The-Stargazist/astro-avionics/vada/VADA.step

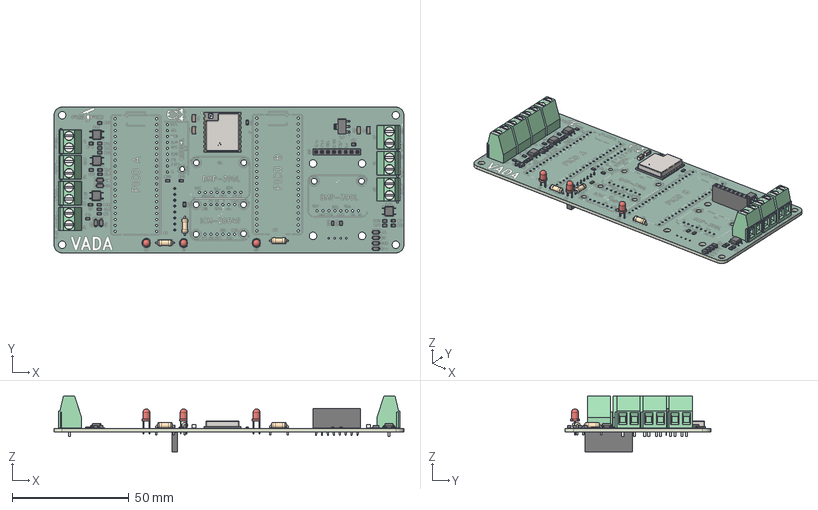
[picture p1: CAD file, 2026-05-24]
vada/VADA.step
150.0 x 62.5 x 24.0 mm
R_0805_2012Metric x 24
TerminalBlock_Phoenix_MKDS-1,5-2_1x02_P5.00mm_Horizontal x 7
WIRELM-SMD_L17.0-W16.0-H3.2-RA-02
D_SOD-123F x 8
LED_D3.0mm x 3
C_1206_3216Metric x 4
SOP-4_3.8x4.1mm_P2.54mm x 4
R_Axial_DIN0207_L6.3mm_D2.5mm_P7.62mm_Horizontal x 3
PinSocket_1x08_P2.54mm_Vertical x 2
SOT-223
VADA_silkscreen
VADA_soldermask
VADA_PCB
