The-Stargazist/astro-avionics/vada/VADA.kicad_pcb

## KiCad design vada/VADA.kicad_pcb (2026-05-24)

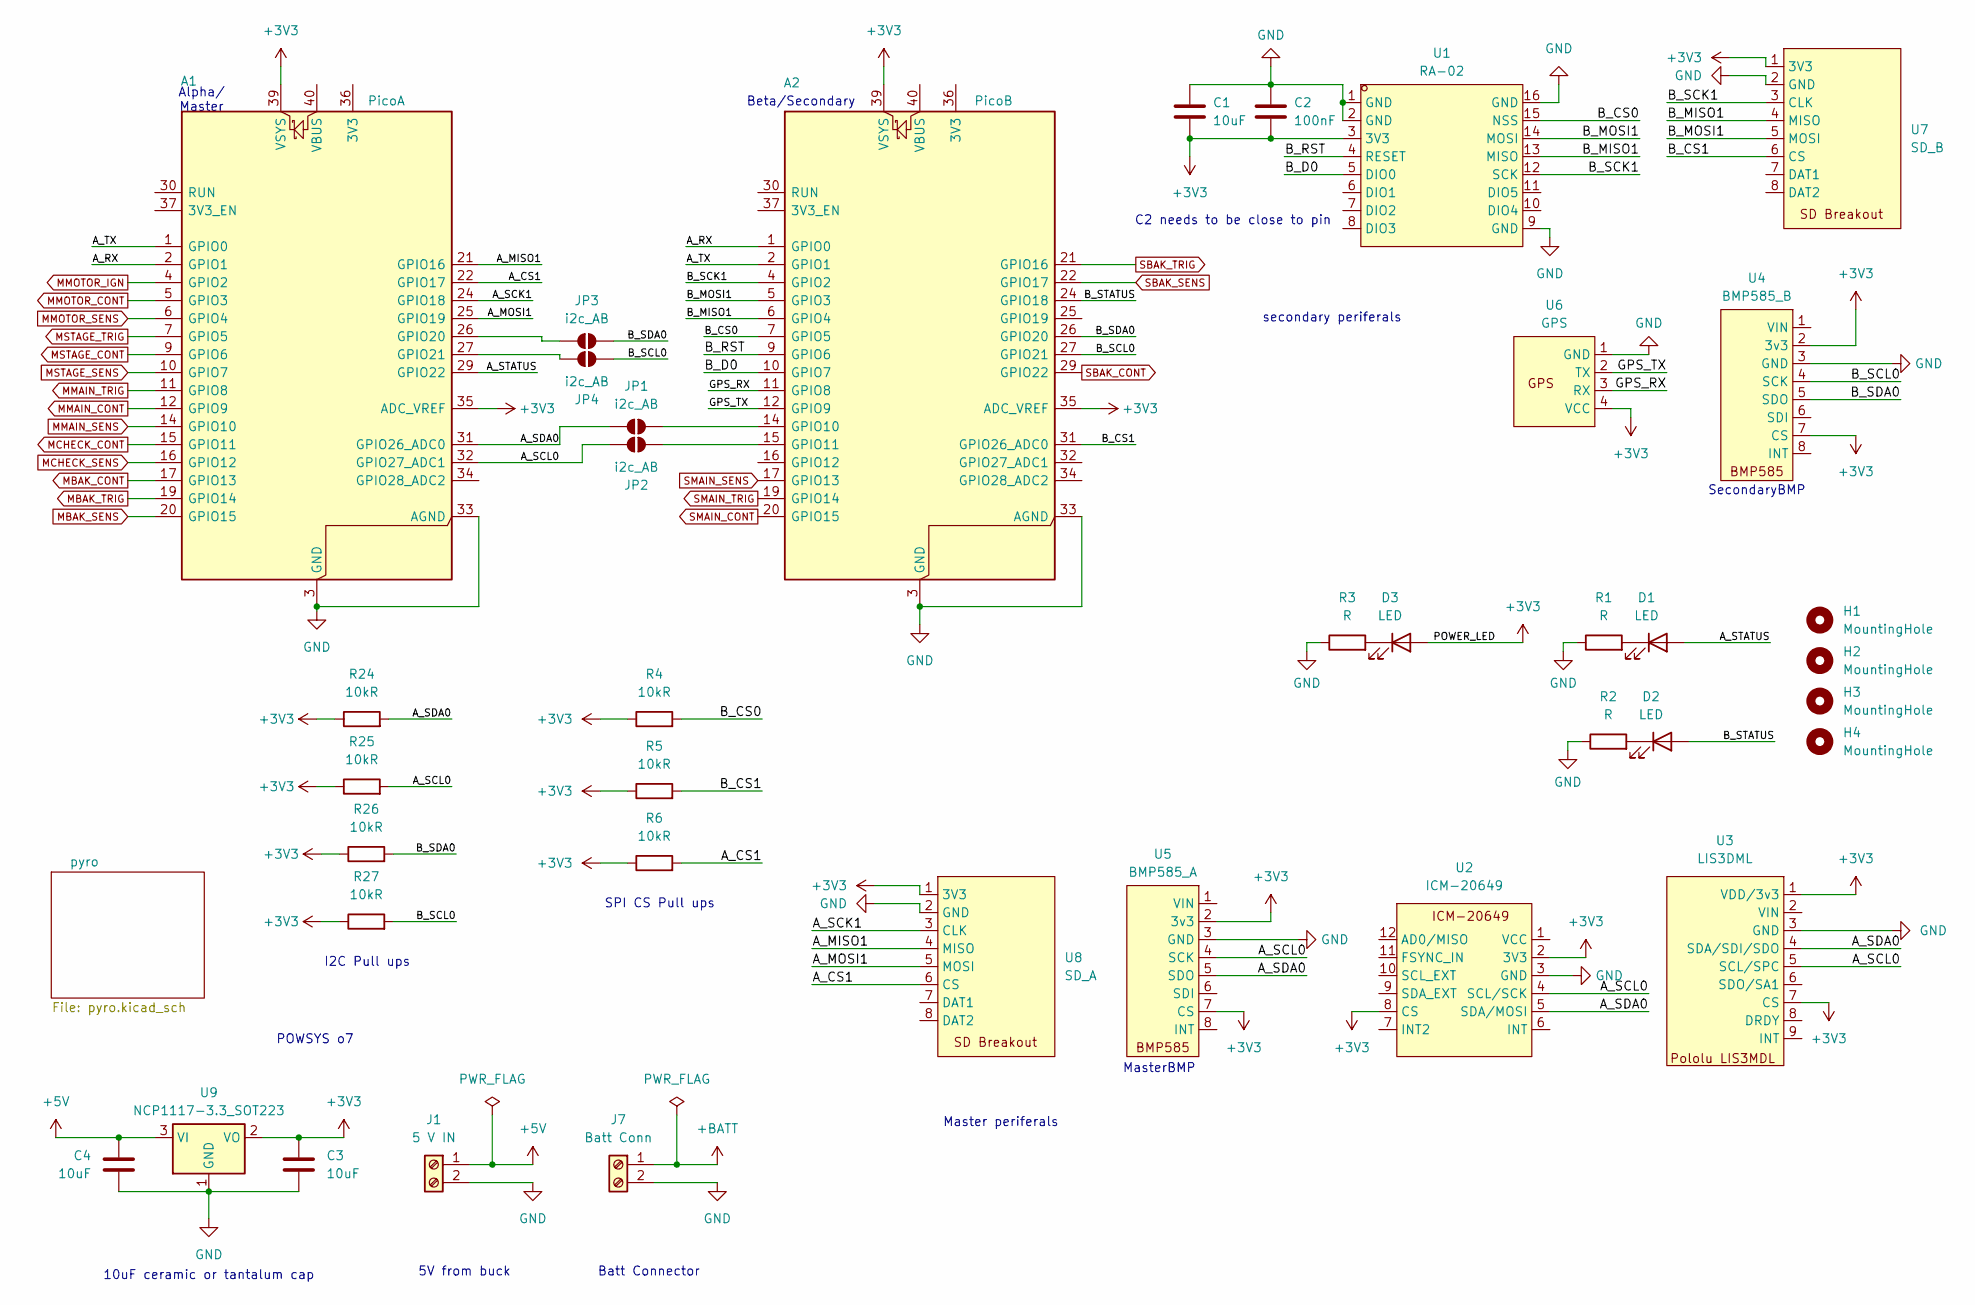
[picture p2: schematic VADA.kicad_sch, Very ADvance Avionics]

Parts:
A1: PicoA; RaspberryPi_Pico_Common_THT
A2: PicoB; RaspberryPi_Pico_Common_THT
C1, C3, C4: 10uF; C_1206_3216Metric_Pad1.33x1.80mm_HandSolder
C2: 100nF; C_1206_3216Metric_Pad1.33x1.80mm_HandSolder
D1, D2, D3: LED; LED_D3.0mm
H1, H2, H3, H4: MountingHole; MountingHole_3.2mm_M3
J1: 5 V IN; TerminalBlock_Phoenix_MKDS-1,5-2_1x02_P5.00mm_Horizontal
J7: Batt Conn; TerminalBlock_Phoenix_MKDS-1,5-2_1x02_P5.00mm_Horizontal
JP1, JP2, JP3, JP4: i2c_AB; SolderJumper-2_P1.3mm_Open_Pad1.0x1.5mm
R1, R2, R3: R; R_Axial_DIN0207_L6.3mm_D2.5mm_P7.62mm_Horizontal
R4, R5, R6, R24, R25, R26, R27: 10kR; R_0805_2012Metric_Pad1.20x1.40mm_HandSolder
U1: RA-02; WIRELM-SMD_RA-02-BL; LCSC Part C90039
U2: ICM-20649
U3: LIS3DML; Pololu LIS3DML
U4: BMP585_B; BMP-390L
U5: BMP585_A; BMP-390L
U6: GPS; M8N GPS
U7: SD_B; PinSocket_1x08_P2.54mm_Vertical
U8: SD_A; PinSocket_1x08_P2.54mm_Vertical
U9: NCP1117-3.3_SOT223; SOT-223-3_TabPin2

Connections:
+3V3: A1.35 (ADC_VREF), A1.39 (VSYS), A2.35 (ADC_VREF), A2.39 (VSYS), C1.2, C2.2, C3.1, D3.2 (A), R4.1, R5.1, R6.1, R24.1, R25.1, R26.1, R27.1, U1.3 (3V3), U2.2 (3V3), U2.8 (CS), U3.1 (VDD/3v3), U3.7 (CS), U4.2 (3v3), U4.7 (CS), U5.2 (3v3), U5.7 (CS), U6.4 (VCC), U7.1 (3V3), U8.1 (3V3), U9.2 (VO)
+5V: C4.1, J1.1, U9.3 (VI)
+BATT: J7.1; also elsewhere on the board
/A_CS1: A1.22 (GPIO17), R6.2, U8.6 (CS)
/A_MISO1: A1.21 (GPIO16), U8.4 (MISO)
/A_MOSI1: A1.25 (GPIO19), U8.5 (MOSI)
/A_RX: A1.2 (GPIO1), A2.1 (GPIO0)
/A_SCK1: A1.24 (GPIO18), U8.3 (CLK)
/A_SCL0: A1.32 (GPIO27_ADC1), JP2.1 (A), R25.2, U2.4 (SCL/SCK), U3.5 (SCL/SPC), U5.4 (SCK)
/A_SDA0: A1.31 (GPIO26_ADC0), JP1.1 (A), R24.2, U2.5 (SDA/MOSI), U3.4 (SDA/SDI/SDO), U5.5 (SDO)
/A_STATUS: A1.29 (GPIO22), D1.2 (A)
/A_TX: A1.1 (GPIO0), A2.2 (GPIO1)
/B_CS0: A2.7 (GPIO5), R4.2, U1.15 (NSS)
/B_CS1: A2.31 (GPIO26_ADC0), R5.2, U7.6 (CS)
/B_D0: A2.10 (GPIO7), U1.5 (DIO0)
/B_MISO1: A2.6 (GPIO4), U1.13 (MISO), U7.4 (MISO)
/B_MOSI1: A2.5 (GPIO3), U1.14 (MOSI), U7.5 (MOSI)
/B_RST: A2.9 (GPIO6), U1.4 (RESET)
/B_SCK1: A2.4 (GPIO2), U1.12 (SCK), U7.3 (CLK)
/B_SCL0: A2.27 (GPIO21), JP4.2 (B), R27.2, U4.4 (SCK)
/B_SDA0: A2.26 (GPIO20), JP3.2 (B), R26.2, U4.5 (SDO)
/B_STATUS: A2.24 (GPIO18), D2.2 (A)
/GPS_RX: A2.11 (GPIO8), U6.3 (RX)
/GPS_TX: A2.12 (GPIO9), U6.2 (TX)
GND: A1.3 (GND), A1.8 (GND), A1.13 (GND), A1.18 (GND), A1.23 (GND), A1.28 (GND), A1.33 (AGND), A1.38 (GND), A2.3 (GND), A2.8 (GND), A2.13 (GND), A2.18 (GND), A2.23 (GND), A2.28 (GND), A2.33 (AGND), A2.38 (GND), C1.1, C2.1, C3.2, C4.2, J1.2, J7.2, R1.1, R2.1, R3.1, U1.1 (GND), U1.2 (GND), U1.9 (GND), U1.16 (GND), U2.3 (GND), U3.3 (GND), U4.3 (GND), U5.3 (GND), U6.1 (GND), U7.2 (GND), U8.2 (GND), U9.1 (GND); also elsewhere on the board
MBAK_CONT: A1.17 (GPIO13); also elsewhere on the board
MBAK_SENS: A1.20 (GPIO15), A2.22 (GPIO17); also elsewhere on the board
MBAK_TRIG: A1.19 (GPIO14); also elsewhere on the board
MCHECK_CONT: A1.15 (GPIO11); also elsewhere on the board
MCHECK_SENS: A1.16 (GPIO12); also elsewhere on the board
MMAIN_CONT: A1.12 (GPIO9); also elsewhere on the board
MMAIN_SENS: A1.14 (GPIO10), A2.17 (GPIO13); also elsewhere on the board
MMAIN_TRIG: A1.11 (GPIO8); also elsewhere on the board
MMOTOR_CONT: A1.5 (GPIO3); also elsewhere on the board
MMOTOR_IGN: A1.4 (GPIO2); also elsewhere on the board
MMOTOR_SENS: A1.6 (GPIO4); also elsewhere on the board
MSTAGE_CONT: A1.9 (GPIO6); also elsewhere on the board
MSTAGE_SENS: A1.10 (GPIO7); also elsewhere on the board
MSTAGE_TRIG: A1.7 (GPIO5); also elsewhere on the board
unnamed: A1.26 (GPIO20), JP3.1 (A)
unnamed: A1.27 (GPIO21), JP4.1 (A)
unnamed: A2.14 (GPIO10), JP1.2 (B)
unnamed: A2.15 (GPIO11), JP2.2 (B)
unnamed: D1.1 (K), R1.2
unnamed: D2.1 (K), R2.2
unnamed: D3.1 (K), R3.2
SBAK_CONT: A2.29 (GPIO22); also elsewhere on the board
SBAK_TRIG: A2.21 (GPIO16); also elsewhere on the board
SMAIN_CONT: A2.20 (GPIO15); also elsewhere on the board
SMAIN_TRIG: A2.19 (GPIO14); also elsewhere on the board

Notes on the sheet:
10uF ceramic or tantalum cap
5V from buck
C2 needs to be close to pin
Batt Connector
SPI CS Pull ups
MasterBMP
Alpha/ Master
Master periferals
POWSYS o7
I2C Pull ups
secondary periferals
SecondaryBMP
Beta/Secondary

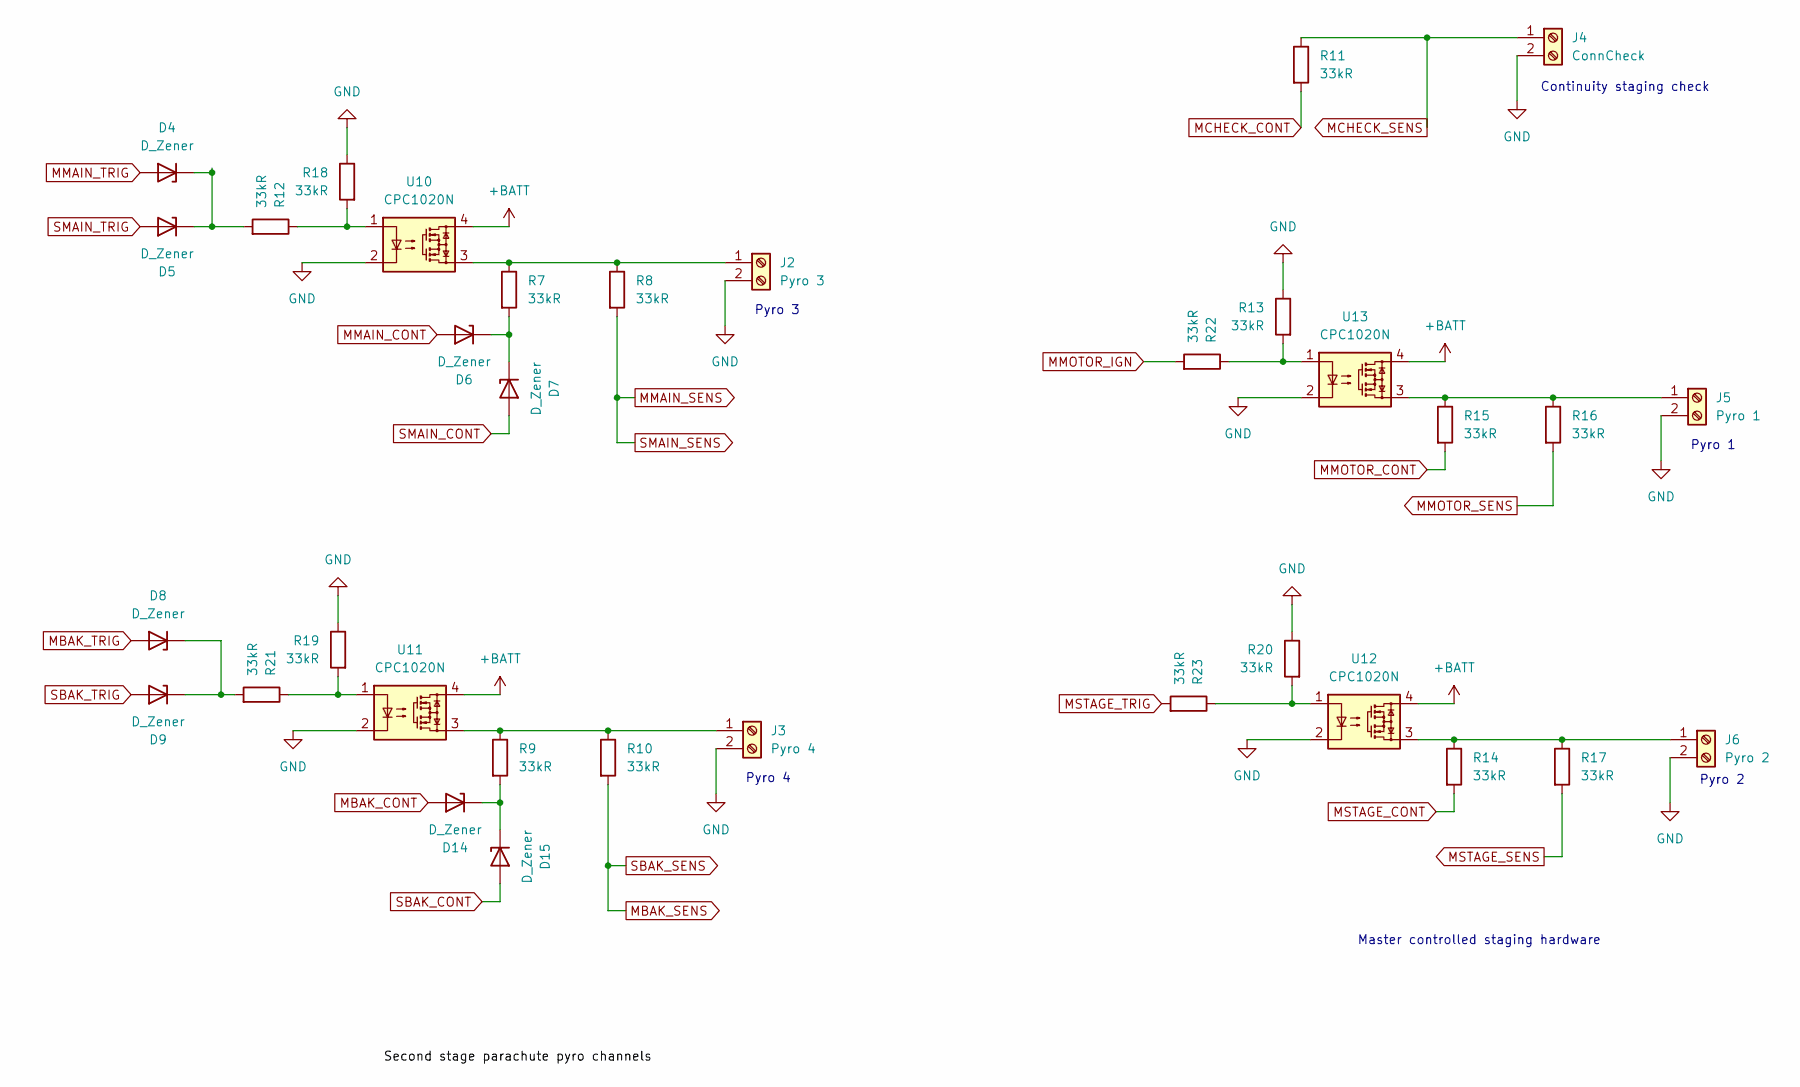
[picture p3: schematic pyro.kicad_sch, VADA]

Parts:
D4, D5, D6, D7, D8, D9, D14, D15: D_Zener; D_SOD-123F
J2: Pyro 3; TerminalBlock_Phoenix_MKDS-1,5-2_1x02_P5.00mm_Horizontal
J3: Pyro 4; TerminalBlock_Phoenix_MKDS-1,5-2_1x02_P5.00mm_Horizontal
J4: ConnCheck; TerminalBlock_Phoenix_MKDS-1,5-2_1x02_P5.00mm_Horizontal
J5: Pyro 1; TerminalBlock_Phoenix_MKDS-1,5-2_1x02_P5.00mm_Horizontal
J6: Pyro 2; TerminalBlock_Phoenix_MKDS-1,5-2_1x02_P5.00mm_Horizontal
R7, R8, R9, R10, R11, R12, R13, R14, R15, R16, R17, R18, R19, R20, R21, R22, R23: 33kR; R_0805_2012Metric_Pad1.20x1.40mm_HandSolder
U10, U11, U12, U13: CPC1020N; SOP-4_3.8x4.1mm_P2.54mm

Connections:
+BATT: U10.4, U11.4, U12.4, U13.4; also elsewhere on the board
GND: J2.2, J3.2, J4.2, J5.2, J6.2, R13.1, R18.1, R19.1, R20.1, U10.2, U11.2, U12.2, U13.2; also elsewhere on the board
MBAK_CONT: D14.2 (A); also elsewhere on the board
MBAK_SENS: R10.2; also elsewhere on the board
MBAK_TRIG: D8.2 (A); also elsewhere on the board
MCHECK_CONT: R11.2; also elsewhere on the board
MCHECK_SENS: J4.1, R11.1; also elsewhere on the board
MMAIN_CONT: D6.2 (A); also elsewhere on the board
MMAIN_SENS: R8.2; also elsewhere on the board
MMAIN_TRIG: D4.2 (A); also elsewhere on the board
MMOTOR_CONT: R15.2; also elsewhere on the board
MMOTOR_IGN: R22.2; also elsewhere on the board
MMOTOR_SENS: R16.2; also elsewhere on the board
MSTAGE_CONT: R14.2; also elsewhere on the board
MSTAGE_SENS: R17.2; also elsewhere on the board
MSTAGE_TRIG: R23.2; also elsewhere on the board
unnamed: D4.1 (K), D5.1 (K), R12.2
unnamed: D6.1 (K), D7.1 (K), R7.2
unnamed: D8.1 (K), D9.1 (K), R21.2
unnamed: D14.1 (K), D15.1 (K), R9.2
unnamed: J2.1, R7.1, R8.1, U10.3
unnamed: J3.1, R9.1, R10.1, U11.3
unnamed: J5.1, R15.1, R16.1, U13.3
unnamed: J6.1, R14.1, R17.1, U12.3
unnamed: R12.1, R18.2, U10.1
unnamed: R13.2, R22.1, U13.1
unnamed: R19.2, R21.1, U11.1
unnamed: R20.2, R23.1, U12.1
SBAK_CONT: D15.2 (A); also elsewhere on the board
SBAK_TRIG: D9.2 (A); also elsewhere on the board
SMAIN_CONT: D7.2 (A); also elsewhere on the board
SMAIN_TRIG: D5.2 (A); also elsewhere on the board

Notes on the sheet:
Continuity staging check
Master controlled staging hardware
Pyro 2
Pyro 4
Pyro 3
Pyro 1

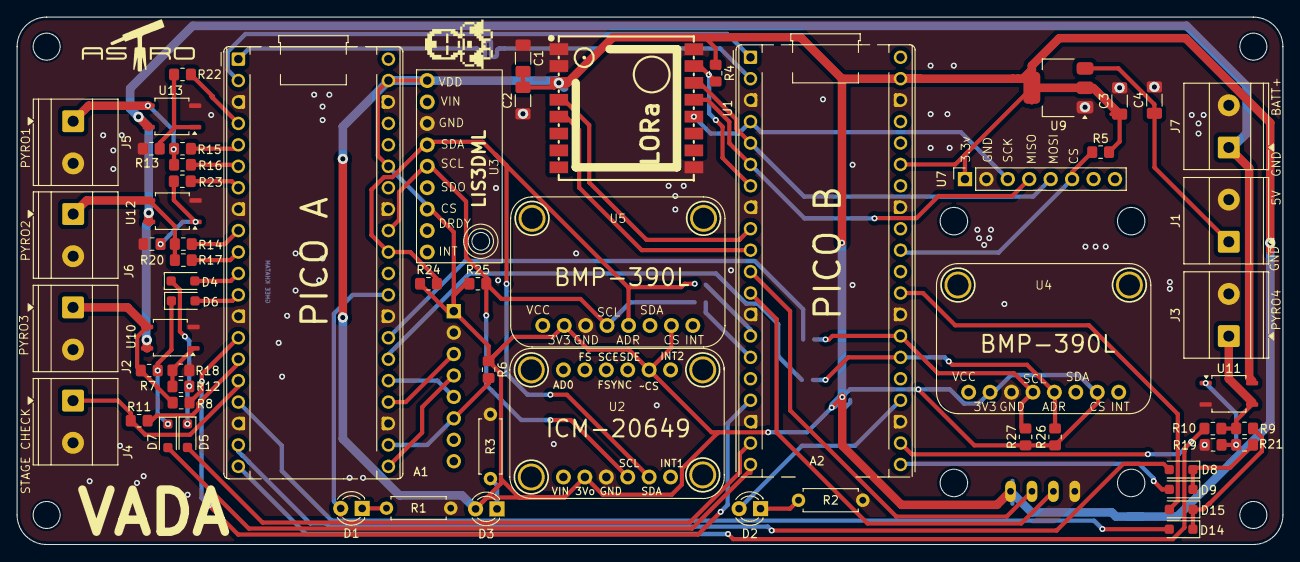
[picture p4: board VADA.kicad_pcb from above]

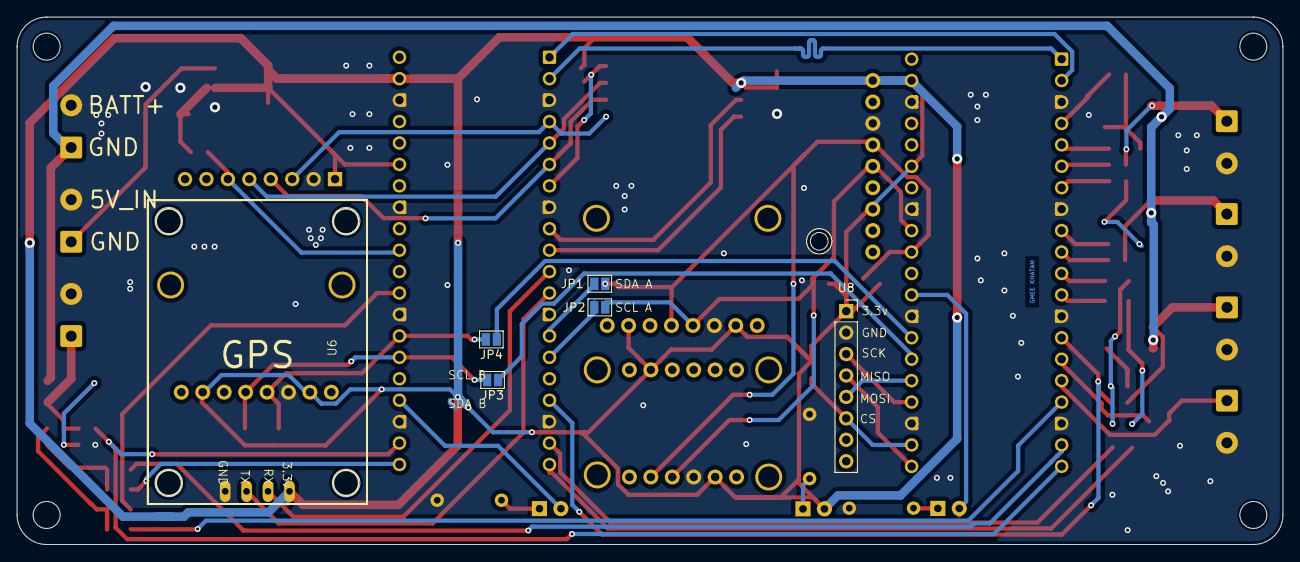
[picture p5: board VADA.kicad_pcb from below]

Board: 2 copper layers, 150.0 x 62.5 mm, 72 parts (6 on the bottom side), 62 nets.
